gtlug/rocketry/SPECS.md

# Specifications

## Full Assembly
<table>
<thead>
<tr>
  <th><ins>Dimension</ins></th>
  <th><ins>Value</ins></th>
  <th><ins>Notes</ins></th>
</tr>
</thead>
<tbody>
  <tr><th>Net Weight</th>
    <td>275g</td>
    <td>Complete w/ telemetry and engine</td>
  </tr>
  <tr><th>Weight (w/o telem)</th>
    <td>147g</td>
    <td>Fully assembled w/ engine, w/o telemetry unit (t-beam)</td>
  </tr>
  <tr><th>Full Height</th>
    <td>--</td>
    <td>Measured from end of engine retainer clip to tip of nose-cone.</td>
  </tr>
</tbody>
</table>

## Quest Courier™ Model Rocket Kit

<table>
<tbody>
  <tr>
    <th>Make</th>
    <td>Quest</td>
    <td rowspan="7">
      Quest Courier™ Model Rocket Kit
    </td>
  </tr>
  <tr><th>Model</th><td>Courier™</td></tr>
  <tr><th>Price</th><td>$13.79</td></tr>
  <tr><th>Length (Full Stock)</th><td>505mm</td></tr>
  <tr><th>Specs</th>
  <td>
    https://aerotech-rocketry.com/products/product_7a612bac-7865-39d5-44a8-a0eb3dc916a9
    <br/>
    https://www.apogeerockets.com/Rocket-Kits/Skill-Level-2-Model-Rocket-Kits/Courier#rocksim
  </td>
  </tr>
  <tr><th>Store</th>
    <td>https://bellevillehobby.com/product/quest-egg-lofter-courier-model-rocket-kit/</td>
  </tr>
  <tr><th>Notes</th>
  <td>
    Ordered 2 of these rockets.  
    I thought having multiple copies of parts might be useful for reference.
    The hobby shop in town didn't have any of these.
  </td>
  </tr>
</tbody>
</table>

### Fuselage Dimensions
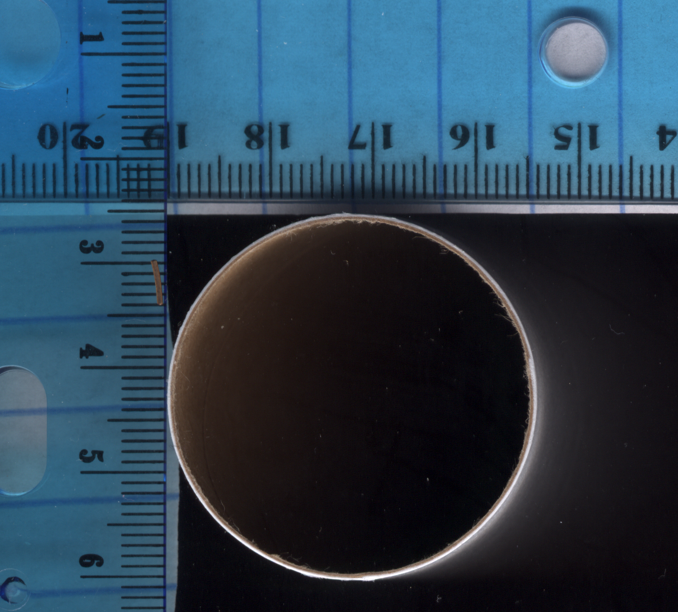
[picture p3: fuselage/Scanned Fuselage Ring Cropped.png]
LILYGO® T-Beam Supreme Perspective View


<table>
<thead>
<tr>
  <th><ins>Dimension</ins></th>
  <th><ins>Value</ins></th>
  <th><ins>Notes</ins></th>
</tr>
</thead>
<tbody>
  <tr><th>Length</th>
    <td>357.5mm</td>
    <td></td>
  </tr>
  <tr><th>Ext. Diameter</th>
    <td>35mm</td>
    <td>These measurements were taken with a caliper ruler.</td>
  </tr>
  <tr><th>Intern. Diameter</th>
    <td>34mm</td>
    <td>Nose-cone mate fits into this diameter</td>
  </tr>
</tbody>
</table>

### Nose-Cone (Quest Courier™ Reference) Dimensions

**Note:** This is only a reference model, that came stock with the kit, 
          and NOT the custom 3D-printed nose-cone dimensions.
<div>
<table>
<thead>
<tr>
  <th><ins>Dimension</ins></th>
  <th><ins>Value</ins></th>
  <th><ins>Notes</ins></th>
  <th></th>
</tr>
</thead>
<tbody>
  <tr><th>Mate Diam</th>
    <td>34mm</td>
    <td></td>
Nose-Cone Profile
    <td rowspan="5"></td>
  </tr>
  <tr><th>Mate Len</th>
    <td>20mm</td>
    <td>Just the cylinder height of nose cone surface in contact with fuselage.</td>
  </tr>
  <tr><th>Addl Mate Recov Len</th>
    <td>20mm</td>
    <td>Length of bit protrusion providing ring to attach recovery parachute and body cable.</td>
  </tr>
  <tr><th>Ext Max Dia</th>
    <td>48mm</td>
    <td>The product nose cone cannot exceed this; else it won't fit on launch pad.</td>
  </tr>
  <tr><th>Ext Length</th>
    <td>171mm</td>
    <td>We can exceed this value to fit.</td>
  </tr>
</tbody>
</table>
</div>

## LILYGO® T-Beam Supreme Dimensions
<div>LILYGO® T-Beam Supreme Perspective View</div>

Visit [LILYGO®'s store][tbeam-store-url] to see other specifications.

<table>
<thead>
<tr>
  <th><ins>Dimension</ins></th>
  <th><ins>Value</ins></th>
  <th><ins>Notes</ins></th>
</tr>
</thead>
<tbody>
  <tr><th>Board Length</th>
    <td>100.75mm</td>
    <td>Ignoring RF-coax and wire wrapping edge</td>
  </tr>
  <tr><th>Full Length</th>
    <td>114.10mm</td>
    <td>Including RF-coax port</td>
  </tr>
  <tr><th>Antenna Len</th>
    <td>109mm</td>
    <td></td>
  </tr>
  <tr><th>Antenna Dia</th>
    <td>10mm</td>
    <td></td>
  </tr>
  <tr><th>Board Width</th>
    <td>32.80mm</td>
    <td>Ignoring tiny buttons on side</td>
  </tr>
  <tr><th>Base Height</th>
    <td>28.00mm</td>
    <td>Including Battery Holder</td>
  </tr>
  <tr><th>Full Height</th>
    <td>29mm</td>
    <td>Including Battery</td>
  </tr>
  <tr><th>Base Mass</th>
    <td>46g</td>
    <td>No battery or SD</td>
  </tr>
  <tr><th>µSD Card</th>
    <td>Standard</td>
    <td>https://en.wikipedia.org/wiki/SD_card</td>
  </tr>
  <tr><th>µSD Card Mass</th>
    <td>0.8g</td>
    <td></td>
  </tr>
  <tr><th>18650 Battery Mass</th>
    <td>49g</td>
    <td></td>
  </tr>
</tbody>
</table>

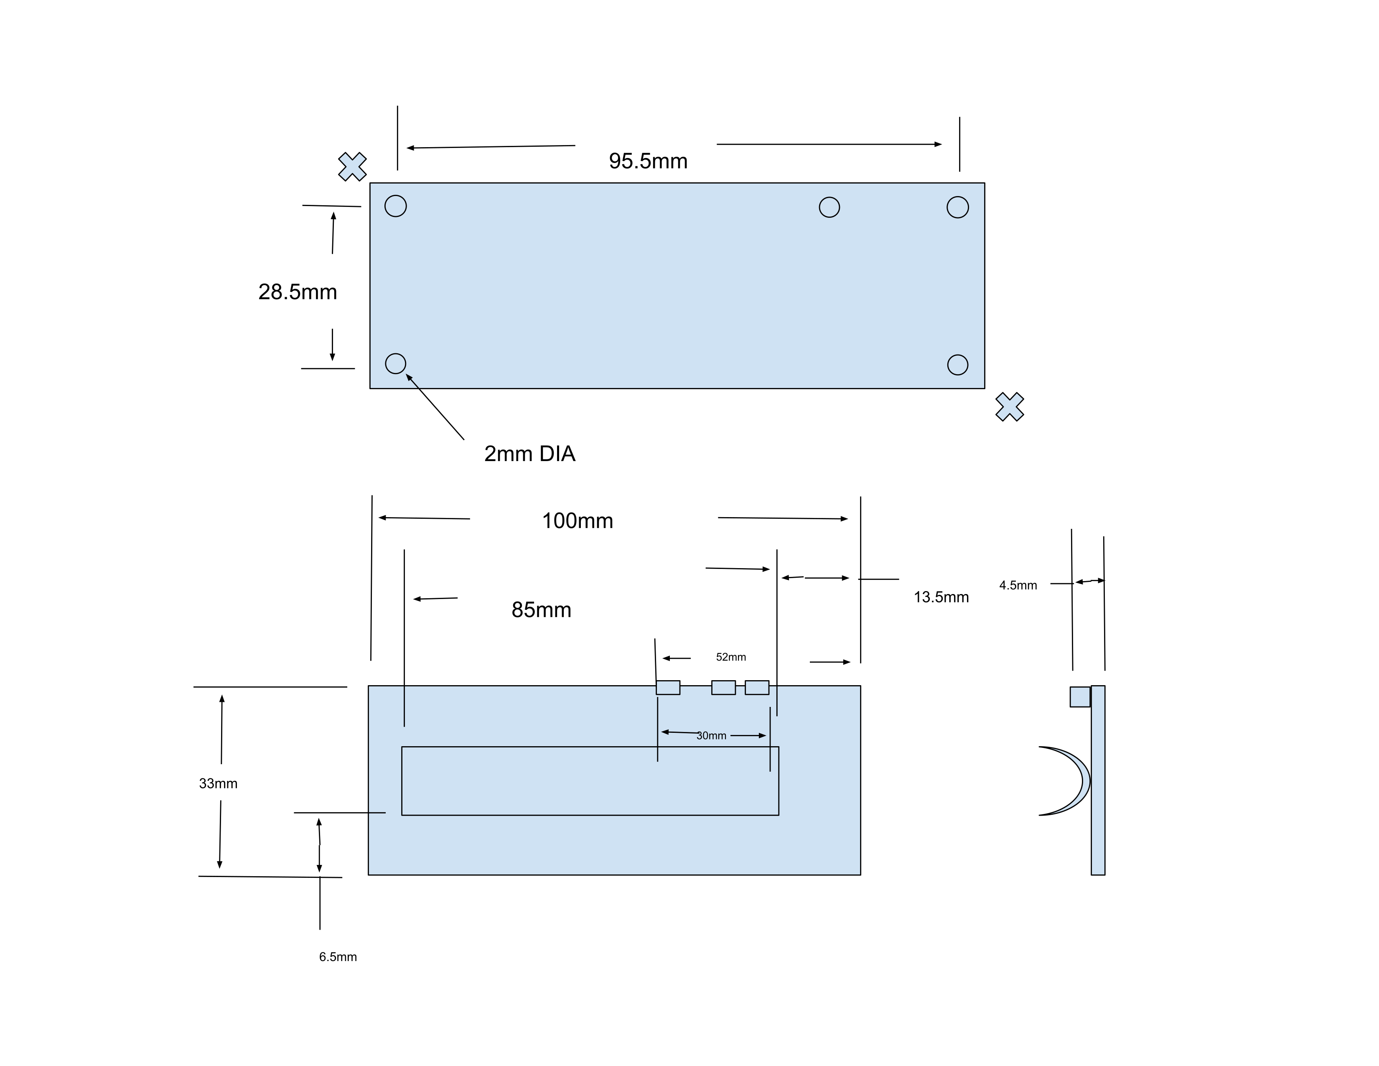
[picture p5: images/t-beam-diagram.png]
T-Beam Supreme sketch with measurements


<!-- MARKDOWN LINKS & IMAGES -->
<!-- https://www.markdownguide.org/basic-syntax/#reference-style-links -->
[rocket-store-url]: https://bellevillehobby.com/product/quest-egg-lofter-courier-model-rocket-kit/
[rocket-specs-url]: https://www.apogeerockets.com/Rocket-Kits/Skill-Level-2-Model-Rocket-Kits/Courier#rocksim
[tbeam-store-url]: https://lilygo.cc/products/t-beam-supreme?variant=44907412193461
[softrf-url]: https://github.com/lyusupov/SoftRF/wiki/Prime-Edition-MkIII
[rtl-sdr-store-url]: https://www.sparkfun.com/rtl-sdr-blog-v3-usb-dongle-with-dipole-antenna-kit.html
[rtl-sdr-specs-url]: https://www.rtl-sdr.com/wp-content/uploads/2018/02/RTL-SDR-Blog-V3-Datasheet.pdf
[hackrf-store-url]: https://www.amazon.com/dp/B0BKH7Z2NJ
[yagi-uda-store-url]: https://www.data-alliance.net/900-mhz-12dbi-yagi-antenna-w-cable-to-n-female/
[sdrpp-url]: https://www.sdrpp.org/
[gnu-radio-url]: https://www.gnuradio.org/
