gtlug/rocketry/FCU_COMPARISON.md

| Property | T-BeamSUPREME U-blox MAX-M10S/915MHz | Teensy 4.1 | SparkFun Thing Plus - ESP32-S3 |
|---|---|---|---|
| Specifications | https://meshtastic.org/docs/hardware/devices/tbeam/?t-beam=supreme | https://www.pjrc.com/store/teensy41.html#specs | https://www.sparkfun.com/products/24408 |
|  | https://github.com/Xinyuan-LilyGO/LilyGo-LoRa-Series |  |  |
| Store | https://www.lilygo.cc/products/t-beamsupreme-softrf?variant=42880905412789 |  | https://www.sparkfun.com/products/24408 |
| Price | $70.17 | $31.50 | $19.95 |
| CPU Model | ESP32-S3FN8 2x-Core LX7 | ARM Cortex-M7 | Dual-Core Xtensa® 32-bit LX7 Processor |
| CPU Clock (MHz) | 240 | 600 | 240 |
| RAM | 8MB | 1024KB | 2MB |
| I2C | 2 | 3 | 2 |
| SPI | 4 | ? | 4 |
| WiFi | 2.4GHz | No | 2.4GHz |
| BLE | Yes | No | Yes |
| GPS | NEO-M10S | No | No |
| µSD Card | Yes | Yes | Yes |
| IMU | QMI8658 | No | No |
| Pressure Sensor | BME280 | No | No |
| Magnetometer | QMC6310 | No | No |
| RTC | PCF8563 | No | No |
| Ethernet | No | DP83825 PHY | No |
