gtlug/rocketry/CAD/bottom Piece.STEP

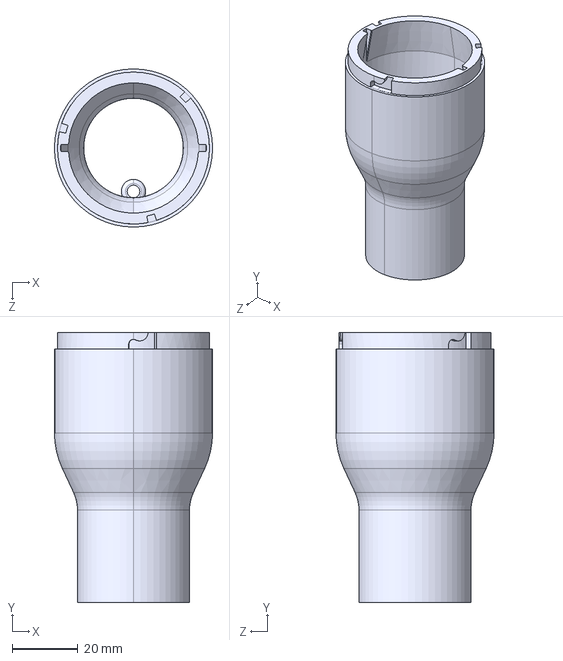
[picture p8: CAD file, 2026-11-05]
CAD/bottom Piece.STEP
48.0 x 81.9 x 48.0 mm
