gtlug/rocketry/CAD/Top Part.STEP

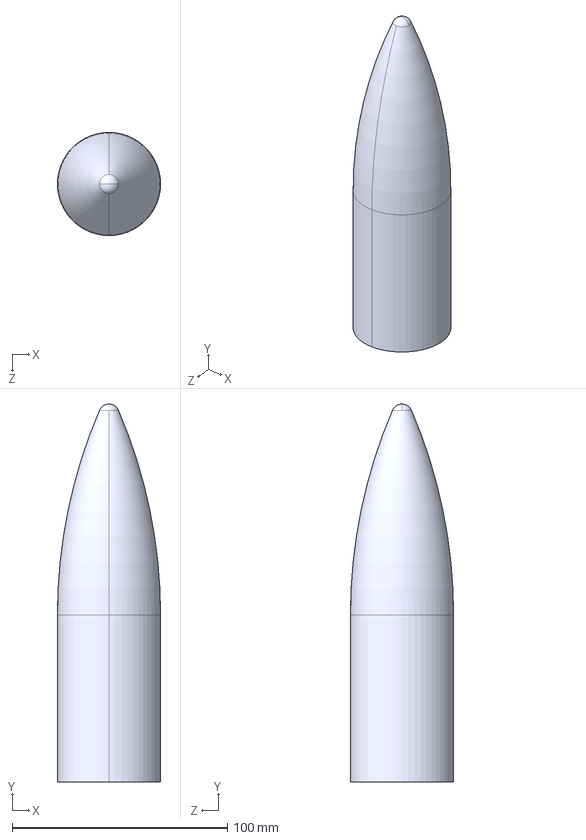
[picture p9: CAD file, 2026-11-05]
CAD/Top Part.STEP
48.0 x 175.8 x 48.0 mm
