gtlug/rocketry/CAD/inside sled.STEP

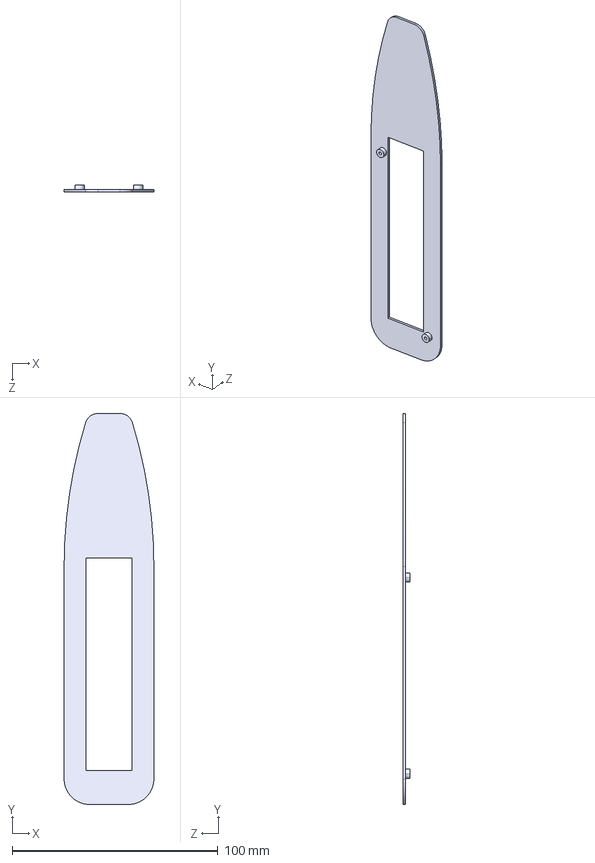
[picture p10: CAD file, 2026-11-05]
CAD/inside sled.STEP
43.7 x 190.2 x 3.56 mm
