gtlug/rocketry/TODO.md

# TODO
## Before GTAS Meeting
- [x] [Download](https://github.com/lyusupov/SoftRF/tree/master/software/firmware/binaries/ESP32S3/SoftRF/MassStorage) firmware v1.9.3
- [x] [Upgrade](https://github.com/lyusupov/SoftRF/blob/master/software/firmware/binaries/README.md#esp32-s3) firmware v1.9.3 on 2nd T-Beam
- [x] Spray color fuselages
- [x] Attach parachutes to shock cord assembly
- [x] Charge batteries
- [x] Add `SPECS.md`
- [x] Add launch schedule
- [x] Add Basic Rocketry Intro
- [x] Install new 32GB µSD in 2nd T-Beam
- [x] Add `DIARY.md`
- [ ] ~~Add build photos (maybe)~~
- [ ] ~~Final nose-cone integration at GTAS~~

## Before Launch
- [x] Charge laptop
- [x] Clear coat finish fuselages
- [x] Wrap new electrical tape handle around Yagi
- [ ] ~~Determine µSD filesystem~~
- [ ] ~~Upgrade 1st T-Beam to v1.9.3~~
- [ ] ~~Apply stickers (maybe later)~~
- [ ] ~~Find batteries for launch controller (batteries tested OK, "ready" light just broken)~~
- [x] Mod other nose-cone base w/ better seal (Deltadragon)
- [x] 1st telemetry module mount to nose-cone sled (Deltadragon)
- [x] Final nose-cone integration at launch site

# Pack List
- [ ] Rocketry Bin
  - [x] Wadding
  - [x] Duct tape
  - [x] Electrical tape
  - [x] Launch pad
  - [x] Launch controller
  - [x] Launch controller batteries
  - [x] WD-40
  - [x] Estes Rocket Engines (As, Bs, and Cs) w/ igniters and plugs
- [x] Test Article Bin
  - [x] 2x rocket fuselages
  - [x] 2x recovery: shock cord, parachute
  - [x] 2x T-Beam Supremes (Deltadragon has)
  - [x] 2x 915MHz omni (Deltadragon has)
  - [ ] 2x nose-cones (Deltadragon has)
- [x] Radio Bin
  - [x] 4x 18650 Li-Ion batteries
  - [x] N to SMA 4' cable
  - [x] SMA extension cable
  - [x] HackRF + USB cable
  - [x] Laptop w/ SDR++
  - [x] USB A-A extension cable
  - [x] Digital scale
  - [x] 3x hand radios (walkie talkies)
- [x] Other
  - [x] Yagi-Uda with N connector
  - [x] Folding table
