gtlug/rocketry/(commit log)

2026-11-04 Update topics in README to reflect current discussions
2026-11-04 Update README with new telemetry module details
    Added details about the Custom 3D-Printed Nose-Cone and LILYGO® T-Beam SUPREME telemetry module to the README.
2026-11-04 Fix formatting for RTL-SDR and Yagi Antenna entries
    Updated frequency and bandwidth formatting for RTL-SDR and 900MHz Yagi Antenna.
2026-11-05 Revise hardware descriptions in README.md
    Updated the description of the LILYGO® T-Beam SUPREME and added the LILYGO® 915MHz Omnidirectional Whip Antenna.
2026-11-05 Update README to include IGC reference for MicroSD
    Clarified the MicroSD card slot functionality by adding a reference to IGC file format.
2026-11-05 Added CAD Files
    Added CAD files and a basic notes document to aid in communication related to the nose cone specifically unrelated to the general PCB and programming aspect of the project.
2026-11-05 Uploaded CAD files
    [Top Part.STEP, bottom Piece.STEP, inside sled.STEP]
2026-11-05 Mark fuselages as sprayed in TODO list
2026-11-06 Added: fuselage related reference materials
2026-11-06 Enhance README with CAD file links and updates
    Added links to CAD files for the 3D-printed nose-cone components and updated the note about CAD files.
2026-11-06 Enhance descriptions of nose-cone parts in README
    Updated descriptions for the 3D-printed nose-cone components for clarity.
2026-11-06 Clarify model file type in README
    Updated the README to clarify the type of model files linked for 3D printing.
2026-11-06 Changed: Batteries charged
2026-11-06 Add specifications for Quest Courier™ Model Rocket Kit
    Added detailed specifications for the Quest Courier™ Model Rocket Kit, including dimensions, pricing, and notes on parts.
2026-11-06 Added: Mass specifications for µSD Card and 18650 Battery
2026-11-06 Create R&D diary for rocket electronics components
    Added comprehensive research and development notes for various hardware components and protocols related to rocket electronics, including Teensy, ESP32, and SoftRF.
2026-11-06 Add image for fuselage dimensions section
2026-11-08 Update SPECS.md with full assembly details
    Added full assembly dimensions and weights to SPECS.md.
2026-11-08 Moved Full Assembly section
