gtlug/rocketry/fuselage/Scanned Nose Profile Cropped.png

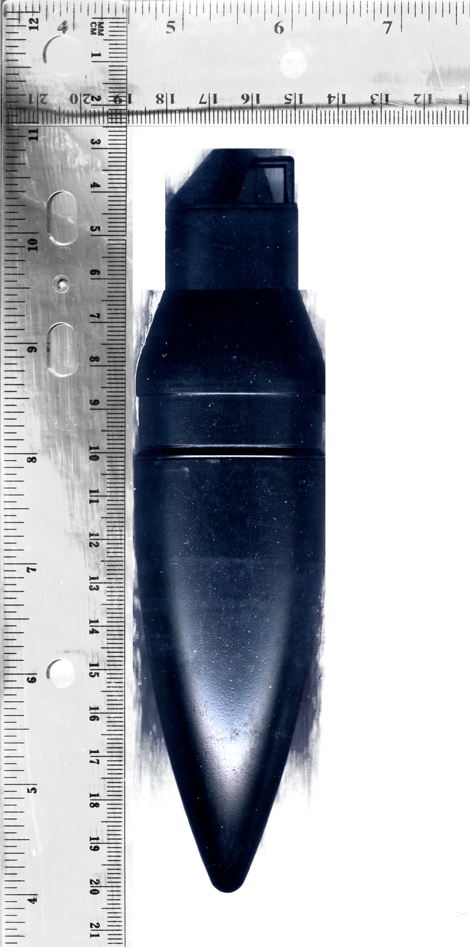
[picture p4: fuselage/Scanned Nose Profile Cropped.png]
fuselage/Scanned Nose Profile Cropped.png
